ttakao/gopro-fc/images/antennna_tape.jpg

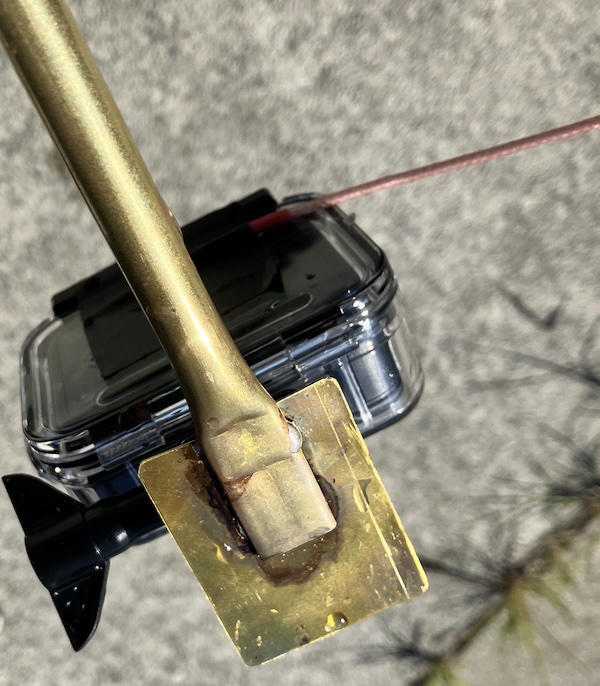
images/antennna_tape.jpg
