ttakao/gopro-fc/(commit log)

2023-10-14 Add antenna picture and start up procedure
2023-10-17 shutter Close command added
    it works only Start specification.
    But code sample sends Stop command. taken same way.
2023-10-17 FIx camera chapter
2023-11-18 Added camera stand documents
2023-11-22 Winch Enable Pin handling correction
2024-06-18 Arduino program updated
    Recognize emergency stop. And renovation.
